username1212121/WRO2021_FutureEngineers/photo/robot_photo/photo_2021-09-23_17-11-24.jpg

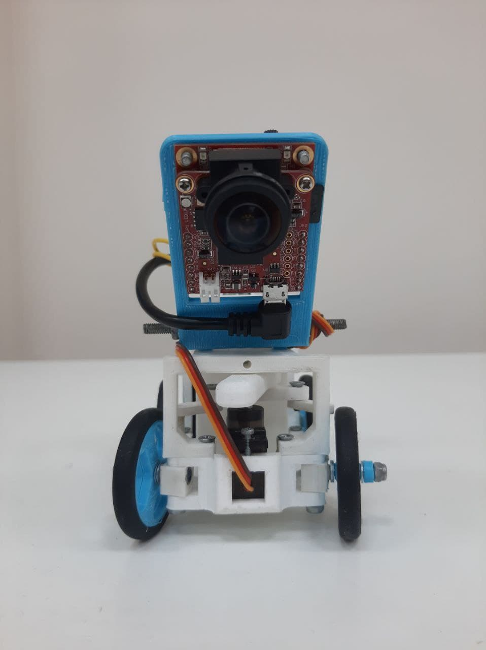
photo/robot_photo/photo_2021-09-23_17-11-24.jpg
