username1212121/WRO2021_FutureEngineers/photo/robot_photo/photo_2021-09-23_17-11-50.jpg

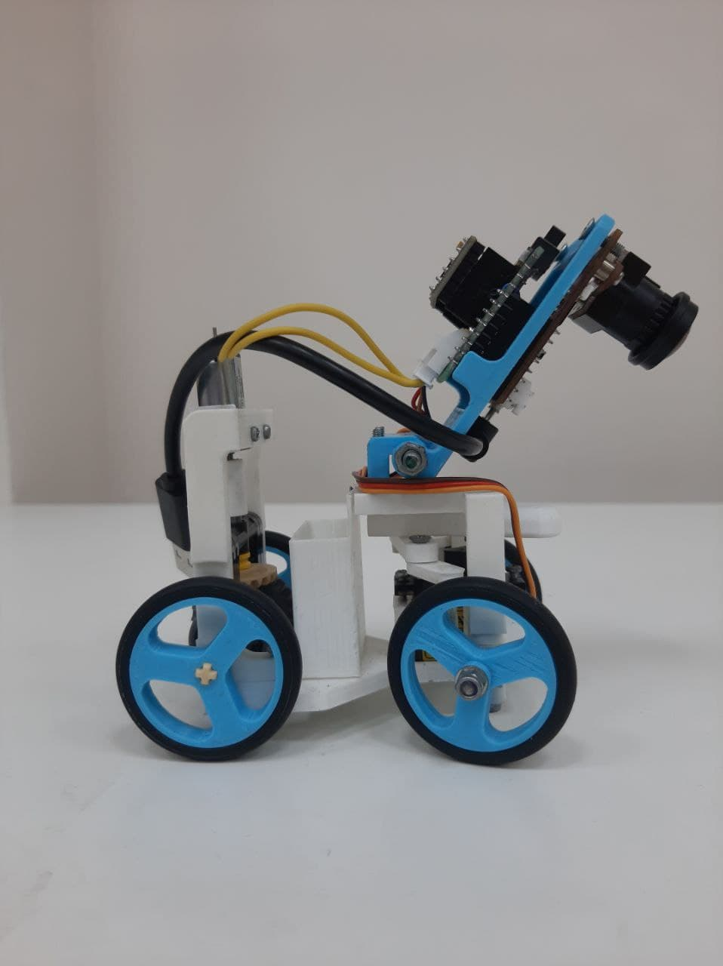
photo/robot_photo/photo_2021-09-23_17-11-50.jpg
