username1212121/WRO2021_FutureEngineers/photo/scheme.png

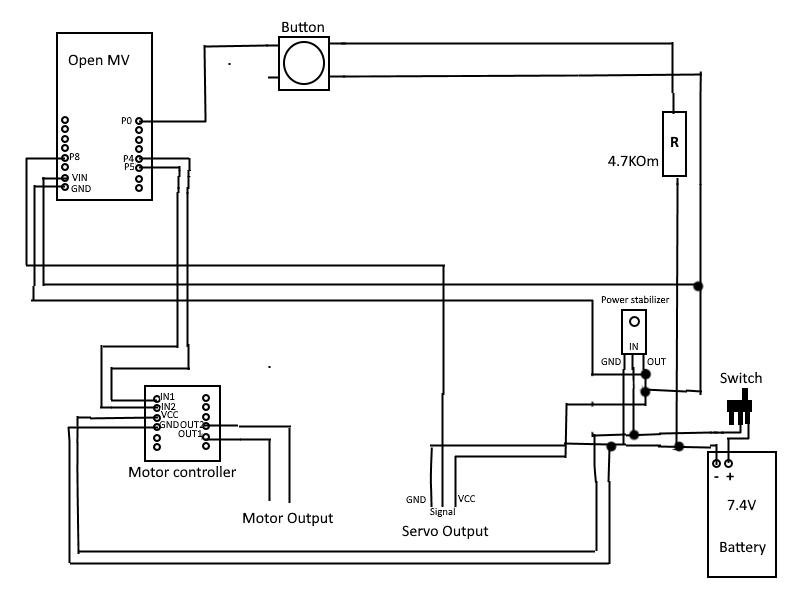
photo/scheme.png
