username1212121/WRO2021_FutureEngineers/photo/team_photo/photo_2021-09-24_12-39-30.jpg

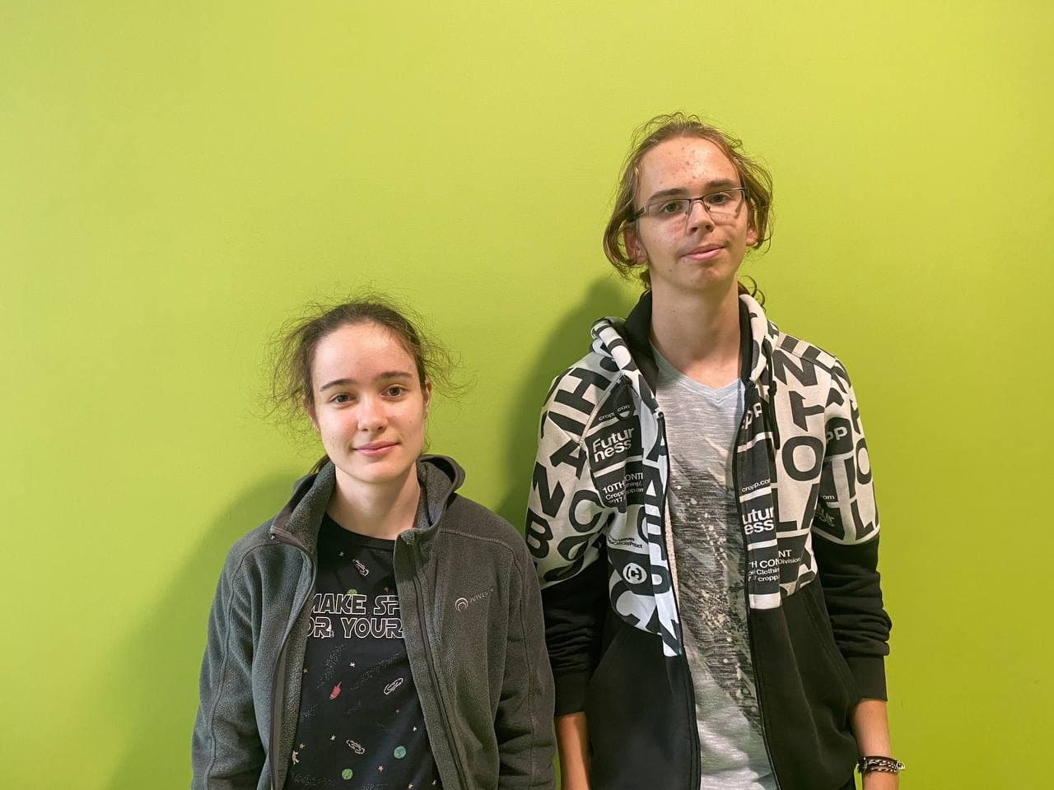
photo/team_photo/photo_2021-09-24_12-39-30.jpg
