username1212121/WRO2021_FutureEngineers/Robot Drawing v1.pdf

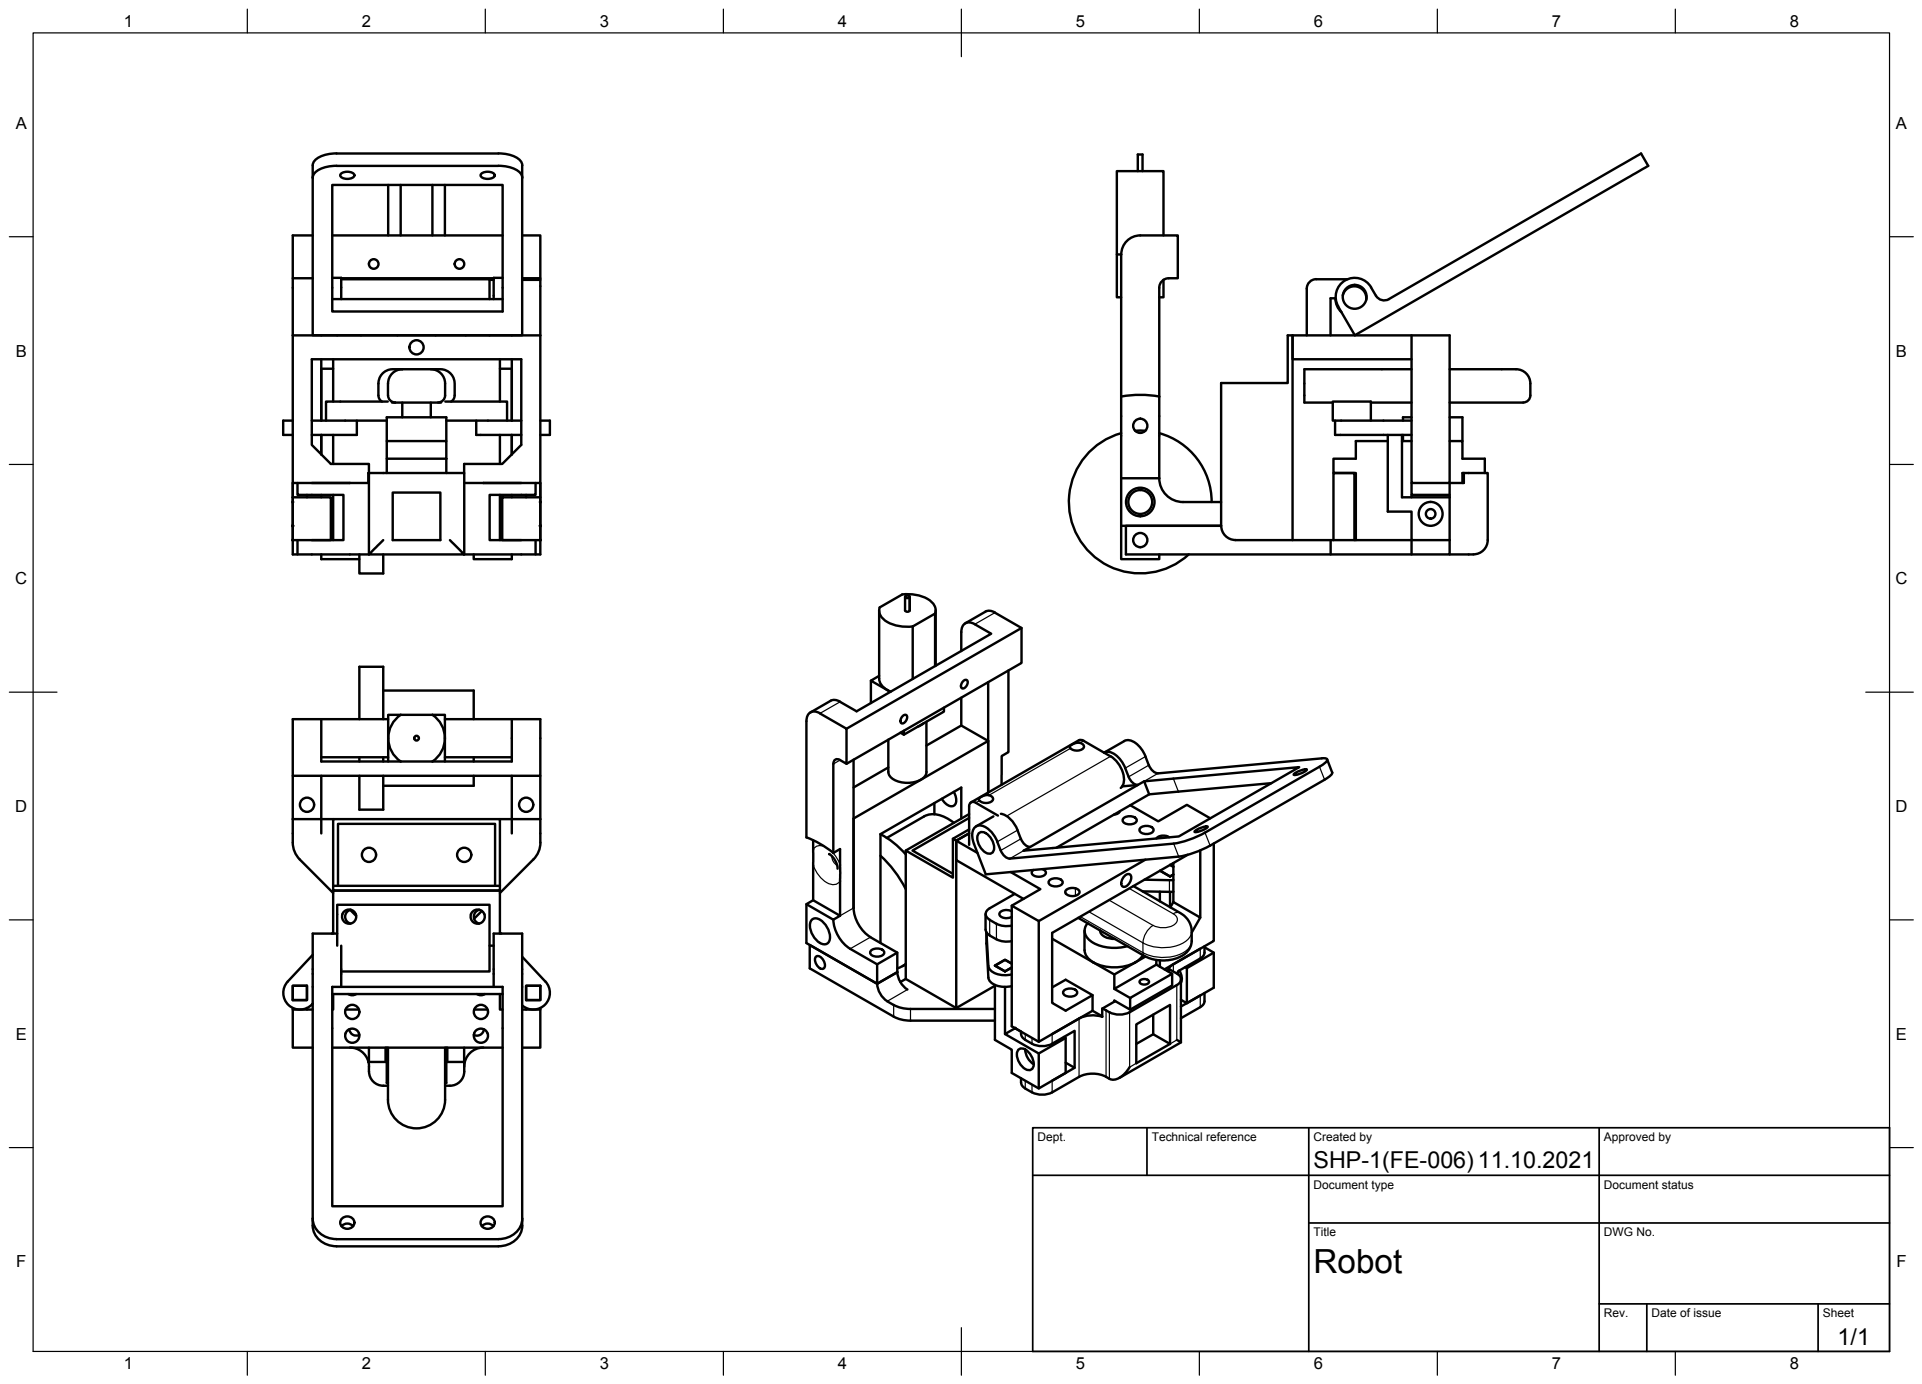
[picture p12: page 1]
Title; DWG No.; Rev.; Date of issue; Sheet

Dept. | Technical reference | Created by SHP-1(FE-006) 11.10.2021 | Approved by

Document type | Document status
