username1212121/WRO2021_FutureEngineers/photo/Main.pdf

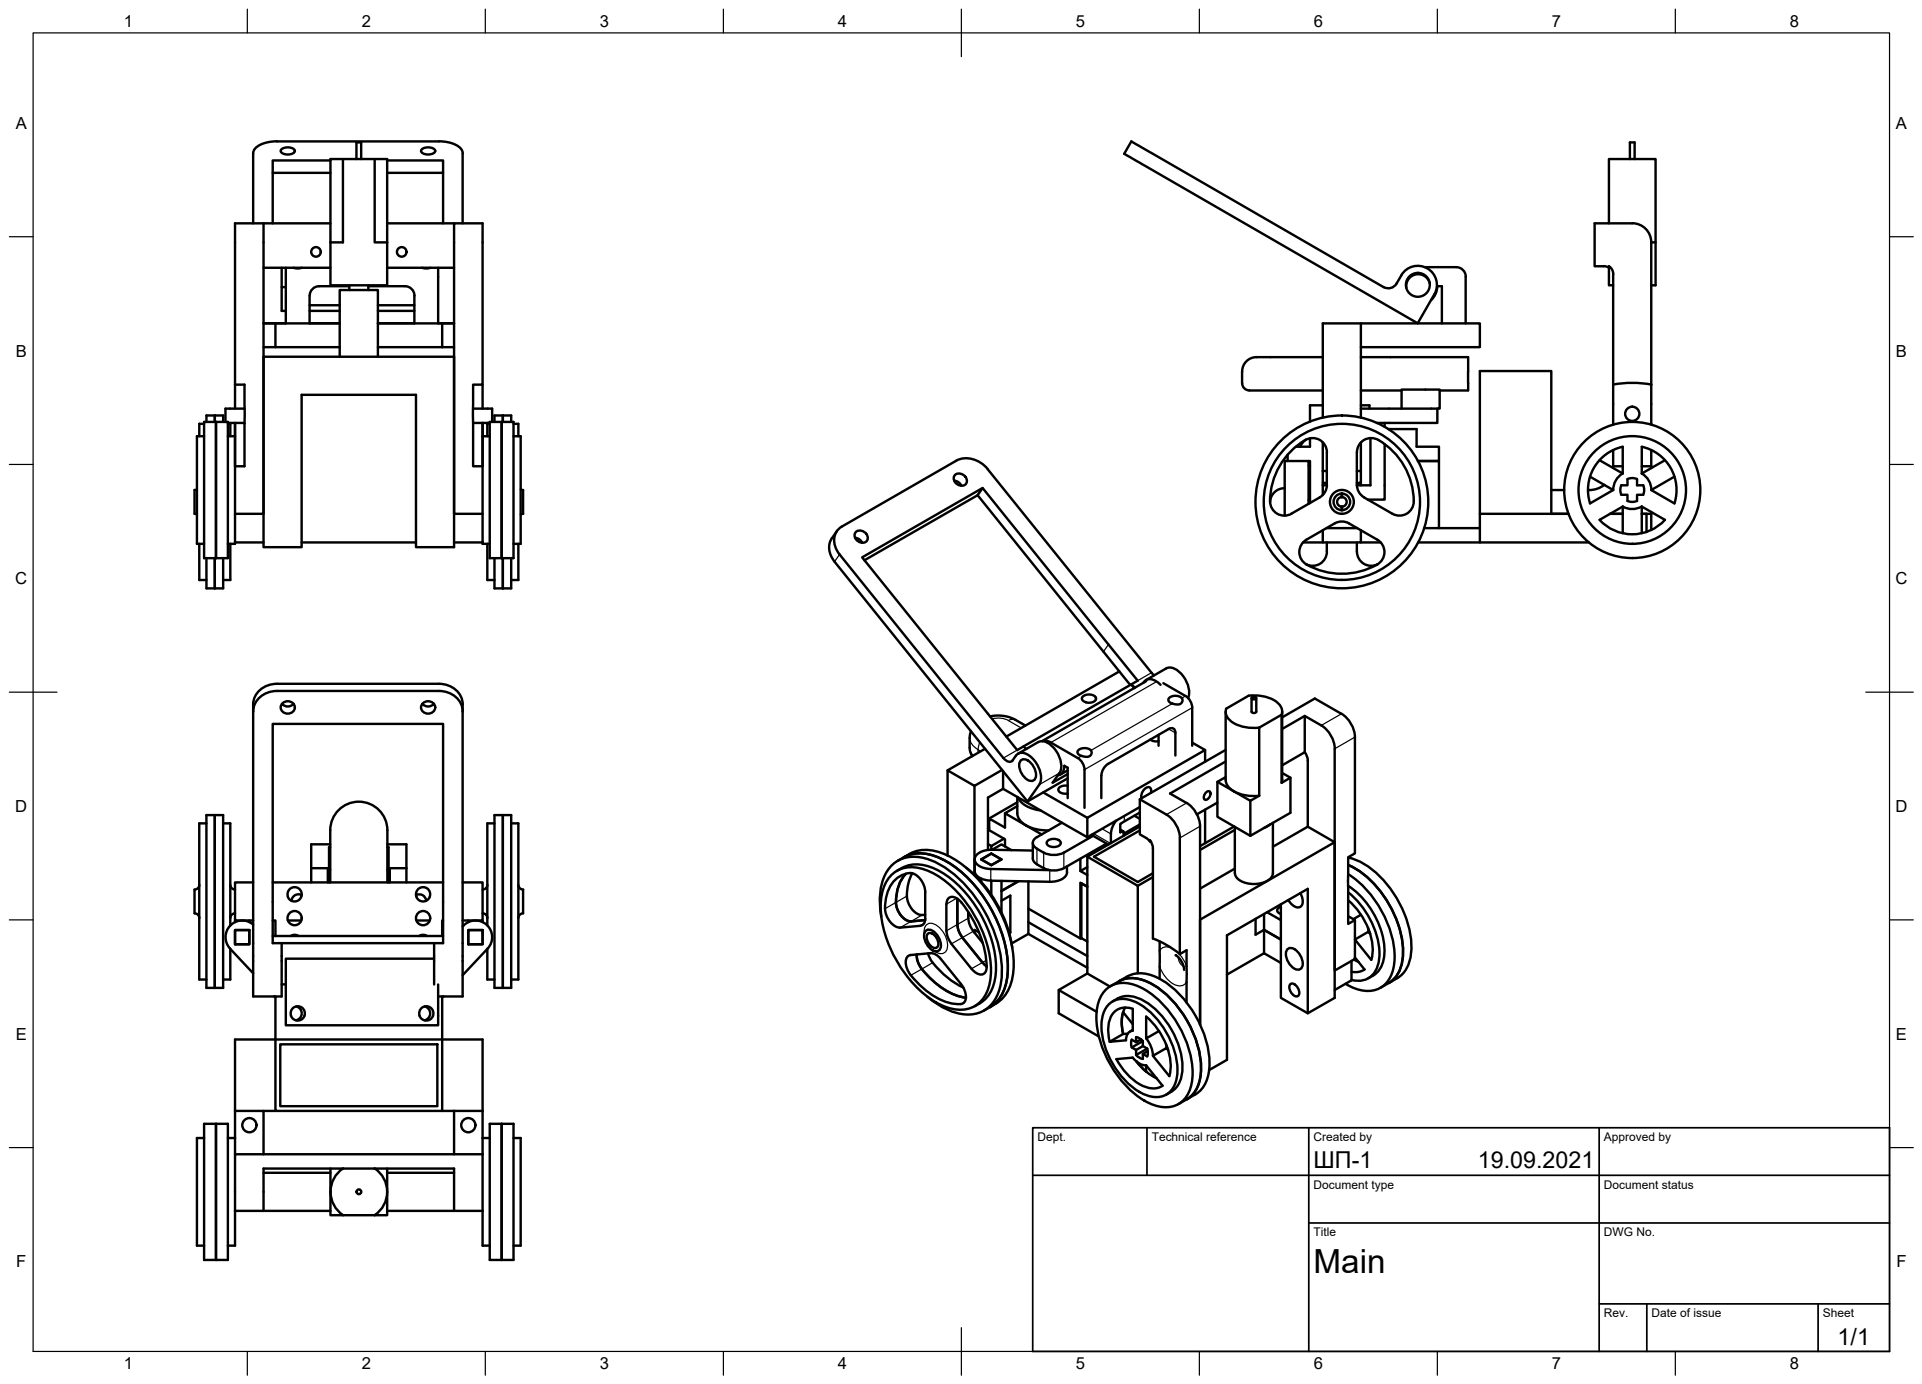
[picture p13: page 1]
Title; DWG No.; Rev.; Date of issue; Sheet

Dept. | Technical reference | Created by ШП-1 19.09.2021 | Approved by

Document type | Document status
