username1212121/WRO2021_FutureEngineers/servo_control_1.py

# Servo Control Example
#
# This example shows how to use your OpenMV Cam to control servos.

import time
from pyb import Servo

s1 = Servo(2) # P7
#s2 = Servo(2) # P8
#s3 = Servo(3) # P9
s1.pulse_width(1550)
for i in range(450):
    s1.pulse_width(1100 - i)

while(True):
    for i in range(900):
        s1.pulse_width(1100 + i)
        #s2.pulse_width(1999 - i)
        #s3.pulse_width(1000 + i)
        time.sleep_ms(5)
    for i in range(900):
        s1.pulse_width(2000 - i)
        #s2.pulse_width(1000 + i)
        #s3.pulse_width(1999 - i)
        time.sleep_ms(5)
