username1212121/WRO2021_FutureEngineers/(commit log)

2021-06-23 New cod with camera & encoders
2021-06-28 New code without encoders
2021-08-24 Add OpenMV code
    This code does not require arduino
2021-08-24 Add code for testing button
2021-08-24 Add code for testing motor
    DRV2833
2021-08-24 Add code for testing servo
2021-09-25 Code for FINAL
    Must work correct
    [main.py]
